eemreeh/Electronic-Desgin-Project-Water-Level-Controller-/README.md

# Electronic-Desgin-Project-Water-Level-Controller-
