eemreeh/Electronic-Desgin-Project-Water-Level-Controller-/raporsim1.0.asc

A1: and; Vhigh=5 Trise=100n Tfall=10n Td=10n
A2: and; Vhigh=5 Trise=100n Tfall=10n Td=10n
A3: diffschmitt; Vhigh=5 Trise=10n Td=10n
A4: diffschmitt; Vt=0 Vh=1m Vhigh=5 Trise=10n Td=10n
Buffer1: AD795
Buffer2: AD795
Buffer3: AD795
C1: polcap; 100µ; V=25 Irms=370m Rser=0.24 Lser=0 mfg="Nichicon" pn="UPL1E101MPH" type="Al electrolytic"
C2: cap; 100n
C6: cap; 1n
Ccontrol1: cap; 0.01µ
Ccontrol: cap; 0.01µ
Cd1: cap; {waterlevel}
Clp1: cap; 10n
Cosc1: cap; 0.001µ
Cosc: cap; 0.001µ
D3: schottky; 1N5819
D4: schottky; 1N5819
DiffAmp: AD795
integrator1: AD795
Lm1: ind; 1m
M1: nmos; FDS4410
M2: nmos; FDS4410
MD1: buf1; Ref=2.5 Vhigh=15 Trise=50n Td=10n
MD2: buf1; Ref=2.5 Vhigh=5 Trise=50n Td=10n
Q1: npn; BC547B
R1: res; 1k
R2: res; 200
R3: res; 5k
R4: res; 10k
R7: res; 5k
R8: res; 4.7k
R9: res; 10k
R10: res; 22k
R11: res; 22k
R13: res; 30k
R14: res; 22k
RA1: res; 4k
RA: res; 1k
Ramp1: res; 10k
Ramp2: res; 330k
RB1: res; 27.2k
RB: res; 6.8k
Rcs1: res; 0.1
Rd1: res; 1k
Rdiff1: res; 10k
Rdiff2: res; 10k
Rdiff3: res; 10k
Rdiff4: res; 10k
Rdiv3: res; 51k
Rdiv4: res; 11k
RLosc1: res; 1k
RLosc: res; 1k
Rlp1: res; 15k
Rm1: res; 4
Rpot1: res; 2k
Rpot2: res; 8k
U1: NE555
U2: AD8030
U4: NE555
U5: AD8030
U6: AD795
U7: AD795
U8: AD8030
V1: voltage; PULSE(0 5 0 0.001u 0.001u 4.999u 10u)
V3: voltage; -15
V4: voltage; 15
Voffset: voltage; 65m
Vp1: voltage; 5V
Vpwr1: voltage; 10V
XOR1: xor; Vhigh = 5 Trise = 10n Td = 10n
XOR2: xor; Vhigh = 5 Trise = 10n Td = 10n
Named nets: 0, DC, Delay, Digital_delayed, Delayed, v-, v+, WienOscillator, CrystalOscillator, 5v, idealOscillator, 555Oscillator, AmplifiedDC, PotOut, DiffAmpOut, 555Oscillator25kHz, Vp, Mdrv, G1, G2, Vpwr, Csns, nOverC, 25MHzTriangularOutput, PWMOut, Enable, -5v
.tran 1ms startup
This circuit convert detected capacitance change information to DC signal with:
- Make a delayed signal with different capacitance values
- Convert this to digital, via an xor gate
- Use the difference in this digital signal and the oscillator to find only the delay signal (to find difference, an xor is used)
- Finally the delay signal (like a pwm signal) can be converted to dc via a basic low pass filter
1. Water Level Detection
.between 5cm to 15cm with 2cm steps
fc = 1.061kHz
ripple is max 5mV
settling time 0.6ms
Potentiometer equivalent
*Values selected from datasheet quick determination graphs
Oscillator circuits
-Water Level Controller-
-Barbaros-
-Emre-
-Ahmet-
Non-inverting Amplifier w/ NegativeDC
Gain = 330/10 + 1 = 34
94-182mV - 94mV ->  1.1 - 3.99V
This circuit converts water level information to desired water amount information with:
- Amplifying the DC voltage to an relatable potentiometer voltage level
- Using voltage divider for potentiometer, we get the desired water level information
- With differential amplifier, circuit gives us the how much water we need
2. Error Amplifier
Power Suppliers
555 Oscillator
Differential Amplifier with equal R's
DiffAmpOut = PotOut - AmplifiedDC
Rtot = 10k
*Values selected from datasheet quick determination graphs
555 Oscillator
.ic I(Lm)=0
Half Bridge Driver:
Two or more of the drivers
 in driver IC can be used in 
parallel to increase current output.
Inductive load that 
models motor winding.
Over-current protection:
Voltage on Rcs current-sense 
resistor is compared with the 
threshold set by R5 and R6.
LM311 or LM393 comparator 
with open-collector output
D1 and D2 are required to circulate the 
load current when both of the driver 
transistors are OFF.  Otherwise, voltage 
at Mdrv can be very high due to Lm*di/dt.
integrator-triangle generator
.step param waterlevel 120p 255p 27p
Simulation Settings
This circuit generates PWM signal with different duty cycles depend on desired water amount with:
- Generates a triangle signal at the integrator circuit
- Amplifing and inverting the output for use at comparator
- Comparing desired water amount and the triangle signal to generate PWM
3. PWM Generation
4. Motor Driver
